Safecast/bGeigieZen/hardware/bGeigieZen V4.x.x draft and production/bGeigieZen V4.2.x/bGeigieZen V4.2.x.kicad_pcb

## KiCad design hardware/bGeigieZen V4.x.x draft and production/bGeigieZen V4.2.x/bGeigieZen V4.2.x.kicad_pcb (2026-08-11)

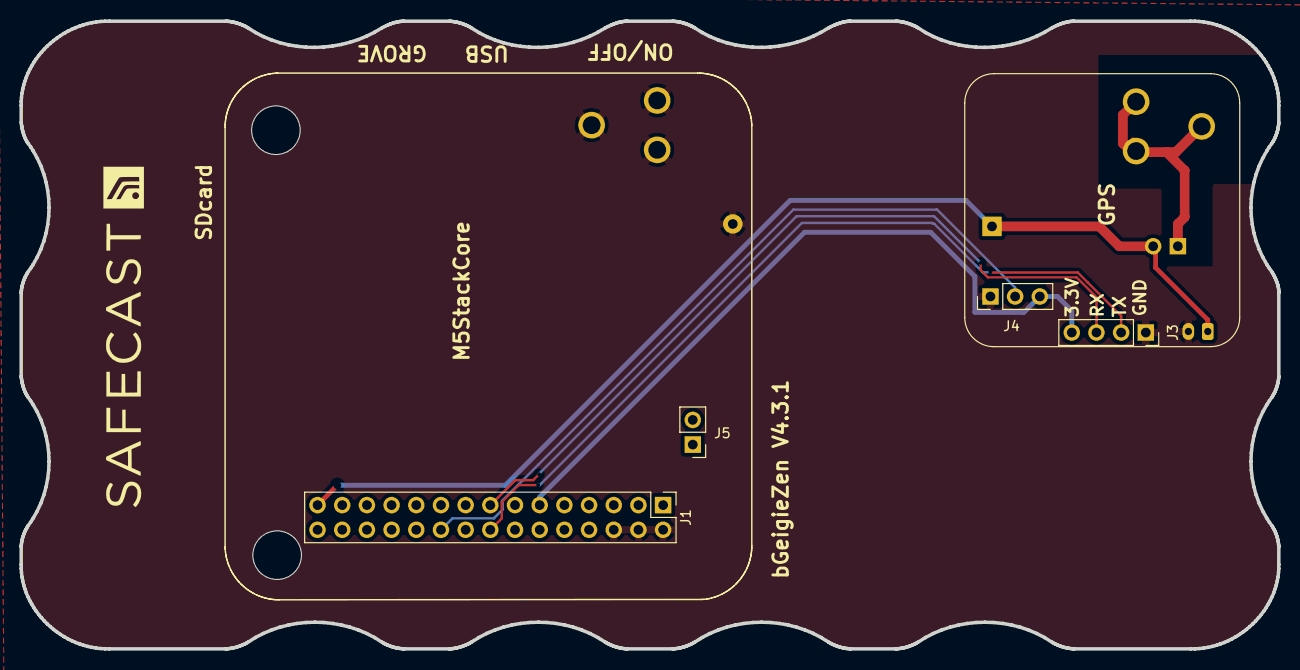
[picture p1: board bGeigieZen V4.2.x.kicad_pcb from above]

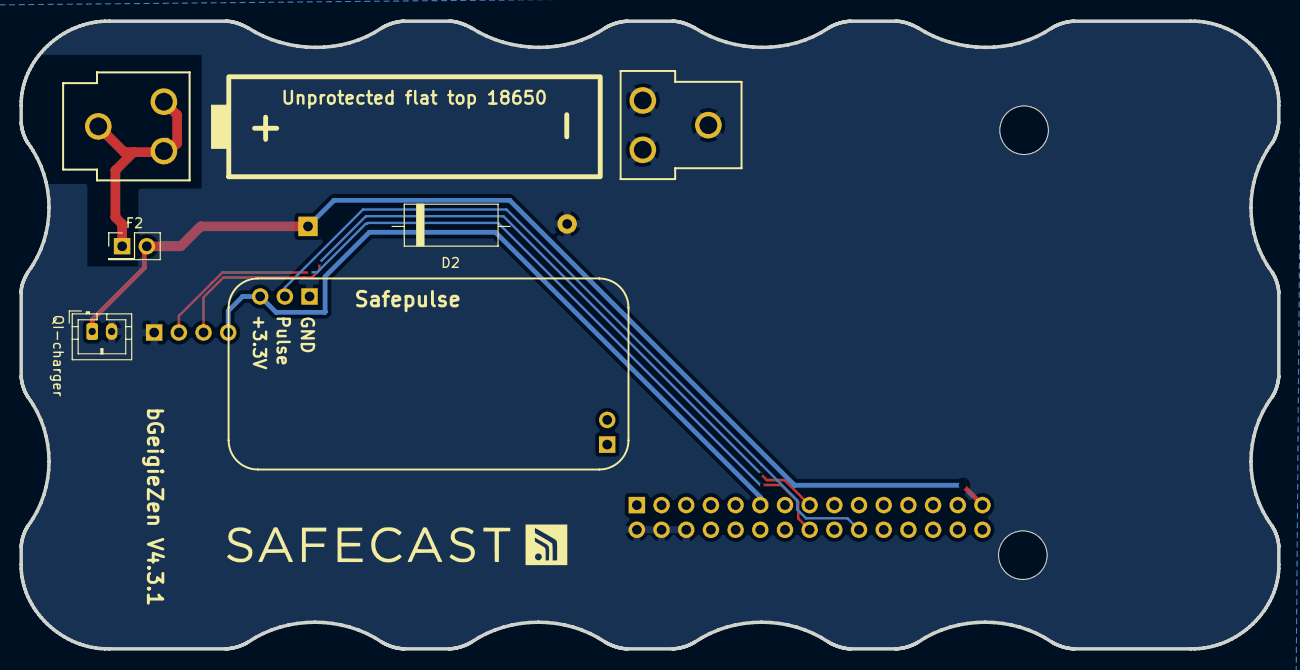
[picture p2: board bGeigieZen V4.2.x.kicad_pcb from below]

Board: 2 copper layers, 129.4 x 64.6 mm, 12 parts (5 on the bottom side), 7 nets.

Parts:
BT1: 3.7 V Lipo; BATTERY_18650-HOLDER
D2: Crowbar; D_DO-201_P15.24mm_Horizontal
F2: Polyfuse; PinHeader_2x01_P2.54mm_Vertical
G back: LOGO
G front: LOGO
H4, H6: MountingHole_Pad; MountingHole_3.2mm_M3
J1: M5 2x15 pin; PinHeader_2x15_P2.54mm_Vertical
J3: GPS; PinSocket_1x04_P2.54mm_Vertical
J4: Geiger Safepulse; PinHeader_1x03_P2.54mm_Vertical
J5: Extra support header; PinHeader_1x02_P2.54mm_Vertical
QI-charger: QI GND; JST_PH_B2B-PH-K_1x02_P2.00mm_Vertical

Connections:
3.3V: J1.11, J3.4, J4.3
/BAT: D2.1 (K), F2.2, J1.29, QI-charger.1
/GIO2 on Core and GIO32 on Core-2: J1.20, J4.2
/RX2: J1.15, J3.3
/TX2: J1.16, J3.2
GND: BT1.1 (+), BT1.PWR@2, BT1.PWR@3, D2.2 (A), J1.2, J1.4, J1.6, J3.1, J4.1, QI-charger.2
unnamed: BT1.1 (+), F2.1
