Safecast/bGeigieZen/hardware/bGeigieZen V3.x.x production/bGeigieZen V3.x.x production.kicad_pcb

## KiCad design hardware/bGeigieZen V3.x.x production/bGeigieZen V3.x.x production.kicad_pcb (2024-08-04)

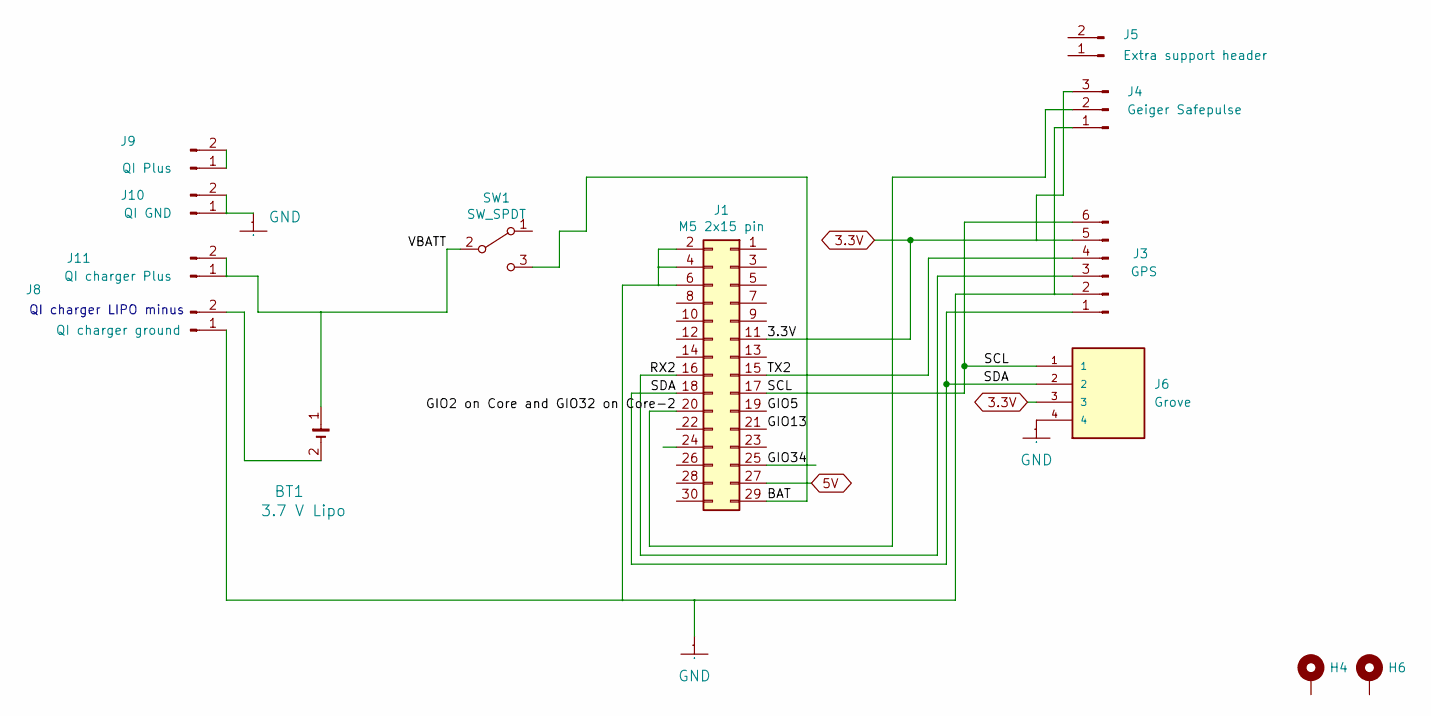
[picture p6: schematic bGeigieZen V3.x.x production.kicad_sch, bGeigieZen V3.0.6]

Parts:
BT1: 3.7 V Lipo; BATTERY_18650-HOLDER
H4, H6: MountingHole_Pad; MountingHole_3.2mm_M3
J1: M5 2x15 pin; PinHeader_2x15_P2.54mm_Vertical
J3: GPS; PinSocket_1x06_P2.54mm_Vertical
J4: Geiger Safepulse; PinHeader_1x03_P2.54mm_Vertical
J5: Extra support header; PinHeader_1x02_P2.54mm_Vertical
J6: Grove; PinSocket_1x04_P2.00mm_Horizontal; PARTREV A
J8: QI charger ground; PinHeader_1x02_P2.54mm_Vertical
J9: QI Plus; PinHeader_1x02_P2.54mm_Vertical
J10: QI GND; PinHeader_1x02_P2.54mm_Vertical
J11: QI charger Plus; PinHeader_1x02_P2.54mm_Vertical_4056
SW1: SW_SPDT; EG1206

Connections:
3.3V: J1.11, J3.5, J4.3, J6.3
5V: J1.27
/BAT: J1.29, SW1.3 (C)
/GIO2 on Core and GIO32 on Core-2: J1.20, J4.2
/GIO5: J1.19
/GIO13: J1.21
/GIO34: J1.25
/RX2: J1.16, J3.3
/SCL: J1.17, J3.6, J6.1
/SDA: J1.18, J3.1, J6.2
/TX2: J1.15, J3.4
/VBATT: BT1.1 (+), BT1.PWR@2, BT1.PWR@3, J11.1, J11.2, SW1.2 (B)
GND: J1.2, J1.4, J1.6, J3.2, J4.1, J6.4, J8.1, J10.1, J10.2
unnamed: BT1.2 (-), J8.2
unnamed: J9.1, J9.2

Notes on the sheet:
QI charger LIPO minus

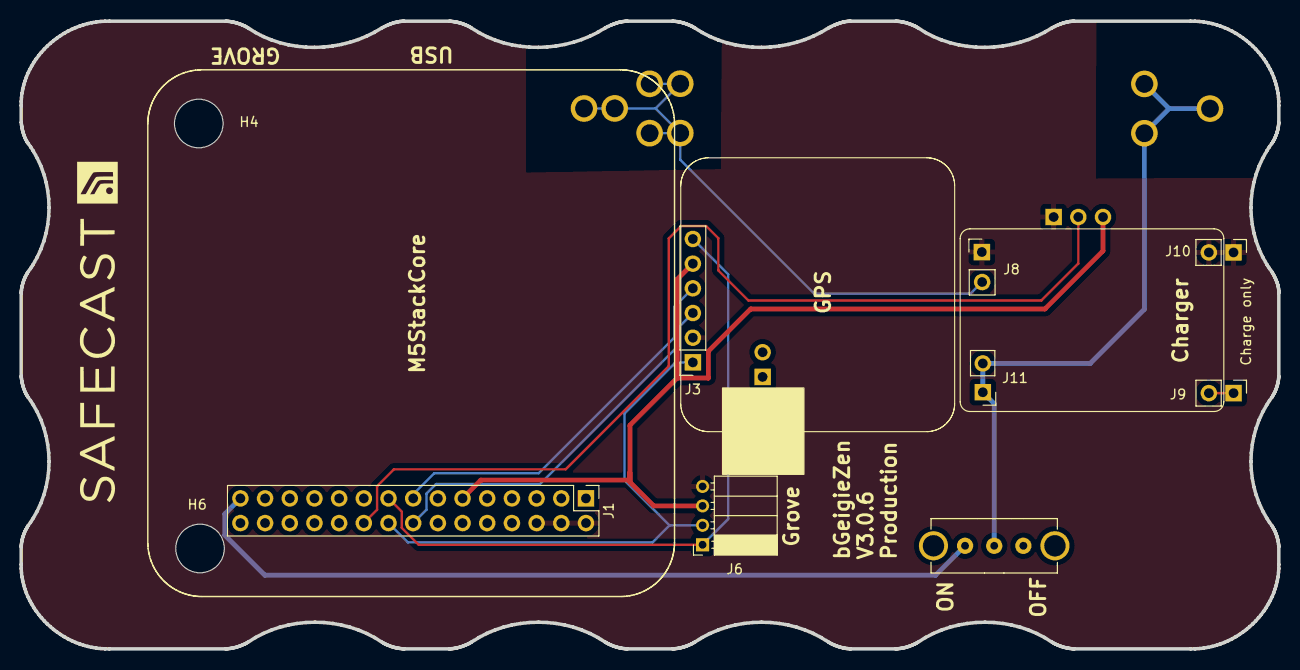
[picture p7: board bGeigieZen V3.x.x production.kicad_pcb from above]

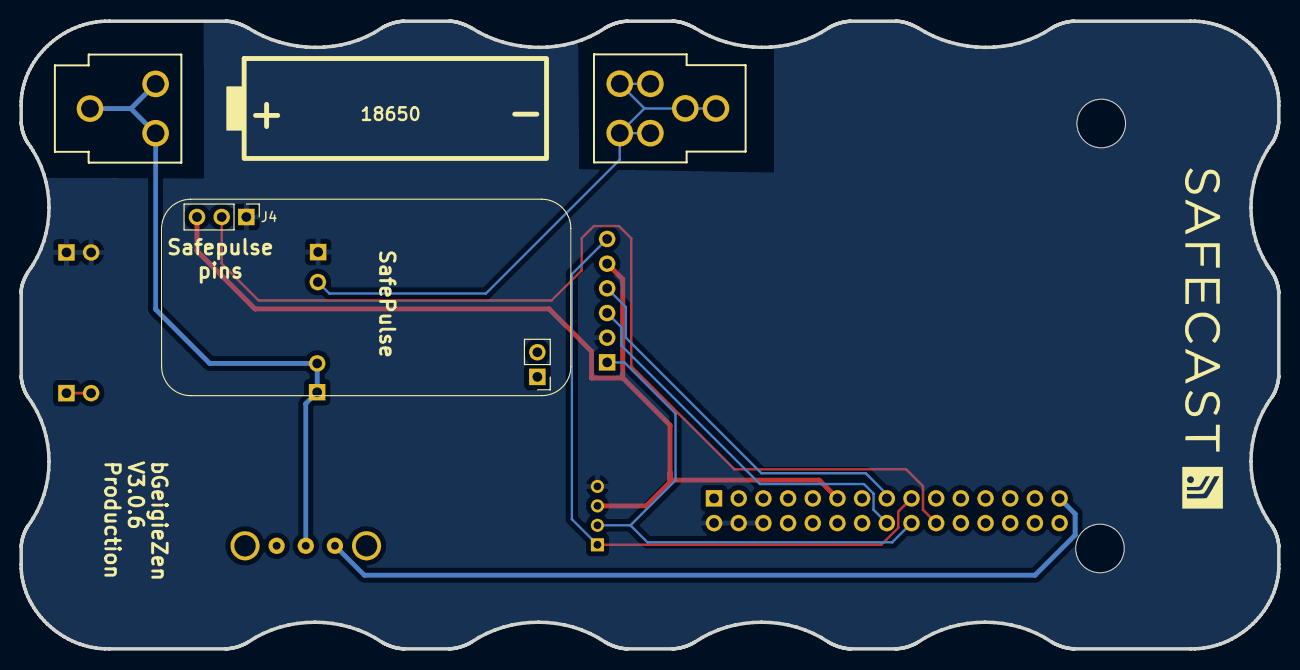
[picture p8: board bGeigieZen V3.x.x production.kicad_pcb from below]

Board: 2 copper layers, 129.4 x 64.6 mm, 15 parts (2 on the bottom side), 11 nets.

Other parts of the board:
G back: LOGO
G front: LOGO
