Safecast/bGeigieZen/hardware/bGeigieZen V4.x.x beta/bGeigieZen V4.x.x beta.kicad_pcb

## KiCad design hardware/bGeigieZen V4.x.x beta/bGeigieZen V4.x.x beta.kicad_pcb (2024-02-28)

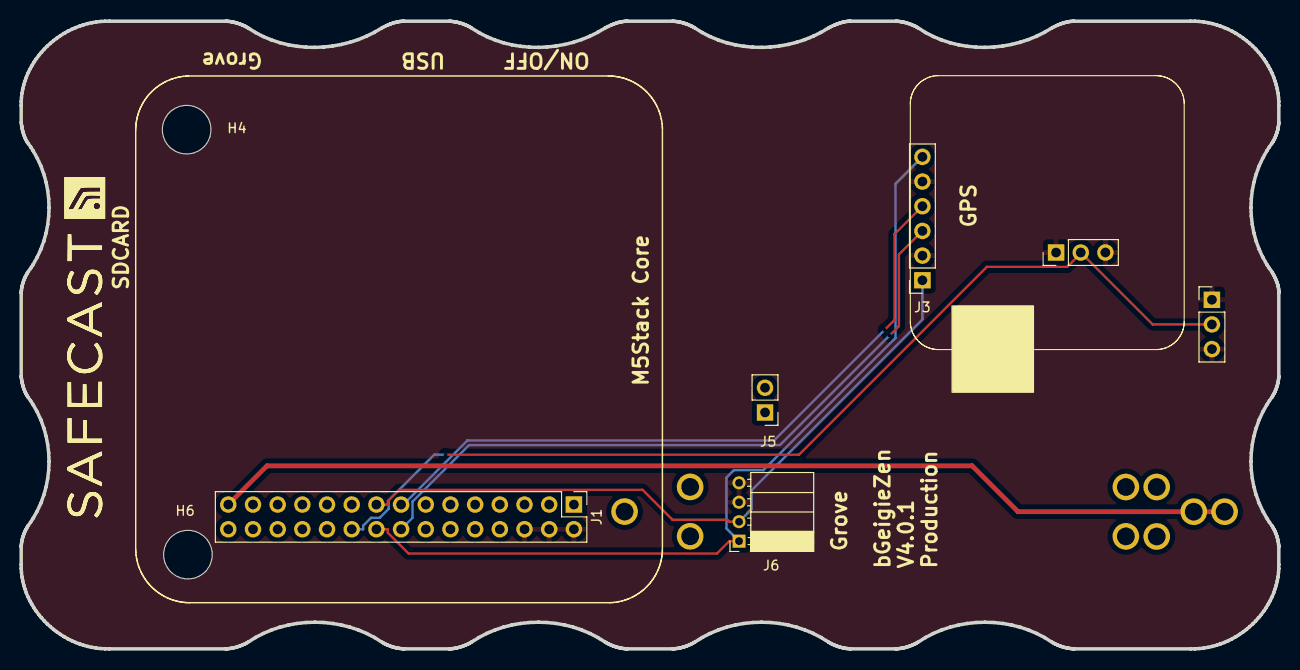
[picture p9: board bGeigieZen V4.x.x beta.kicad_pcb from above]

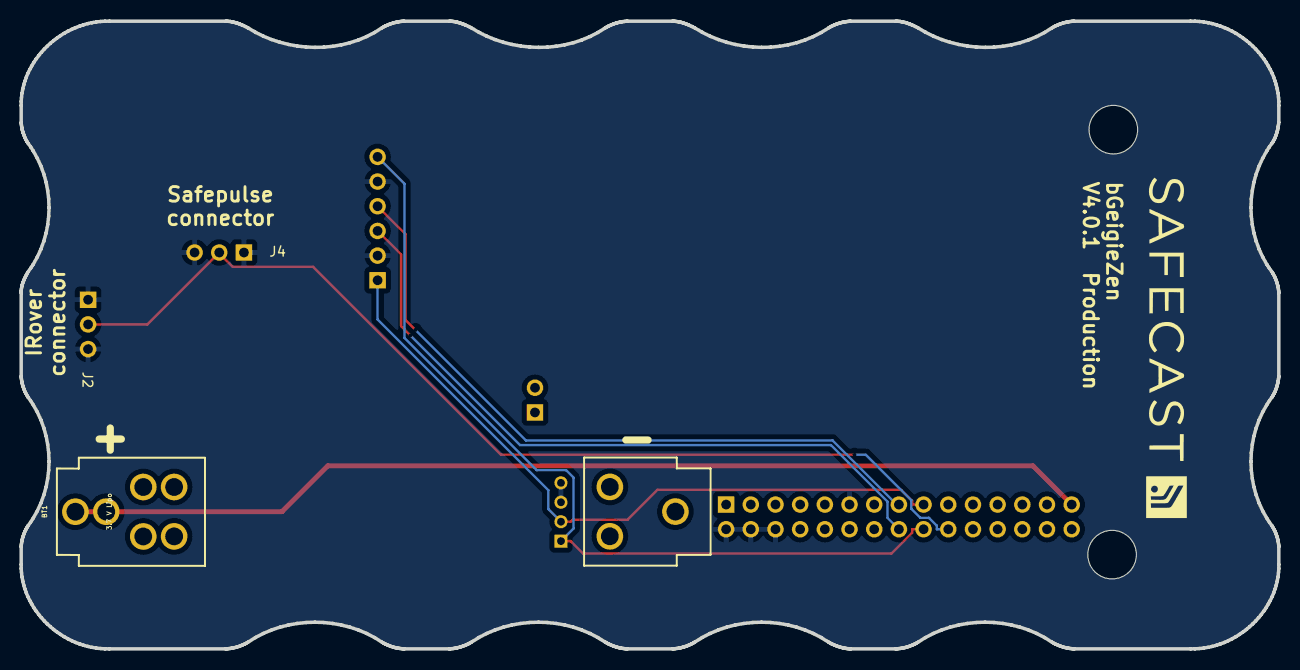
[picture p10: board bGeigieZen V4.x.x beta.kicad_pcb from below]

Board: 2 copper layers, 129.4 x 64.6 mm, 11 parts (2 on the bottom side), 7 nets.

Parts:
BT1: 3.7 V Lipo; BATTERY_18650-HOLDER
G back: LOGO
G front: LOGO
H4, H6: MountingHole_Pad; MountingHole_3.2mm_M3
J1: M5 2x15 pin; PinHeader_2x15_P2.54mm_Vertical
J2: Geiger IRover; PinHeader_1x03_P2.54mm_Vertical
J3: GPS; PinSocket_1x06_P2.54mm_Vertical
J4: Geiger Safepulse; PinHeader_1x03_P2.54mm_Vertical
J5: Extra support header; PinHeader_1x02_P2.54mm_Vertical
J6: Grove; PinSocket_1x04_P2.00mm_Horizontal

Connections:
3.3V: J1.2, J1.4, J1.6, J1.11, J2.1, J2.3, J3.2, J3.5, J4.1, J4.3, J6.3, J6.4
/BAT: BT1.1 (+), J1.29
/GIO2 on Core and GIO32 on Core-2: J1.20, J2.2, J4.2
/RX2: J1.15, J3.4
/SCL: J1.18, J3.6, J6.1
/SDA: J1.17, J3.1, J6.2
/TX2: J1.16, J3.3
