Safecast/bGeigieZen/hardware/bGeigieZen V4.x.x draft and production/bGeigieZen V4.2.x/temp copy.kicad_pcb

## KiCad design hardware/bGeigieZen V4.x.x draft and production/bGeigieZen V4.2.x/temp copy.kicad_pcb (2020-07-29)

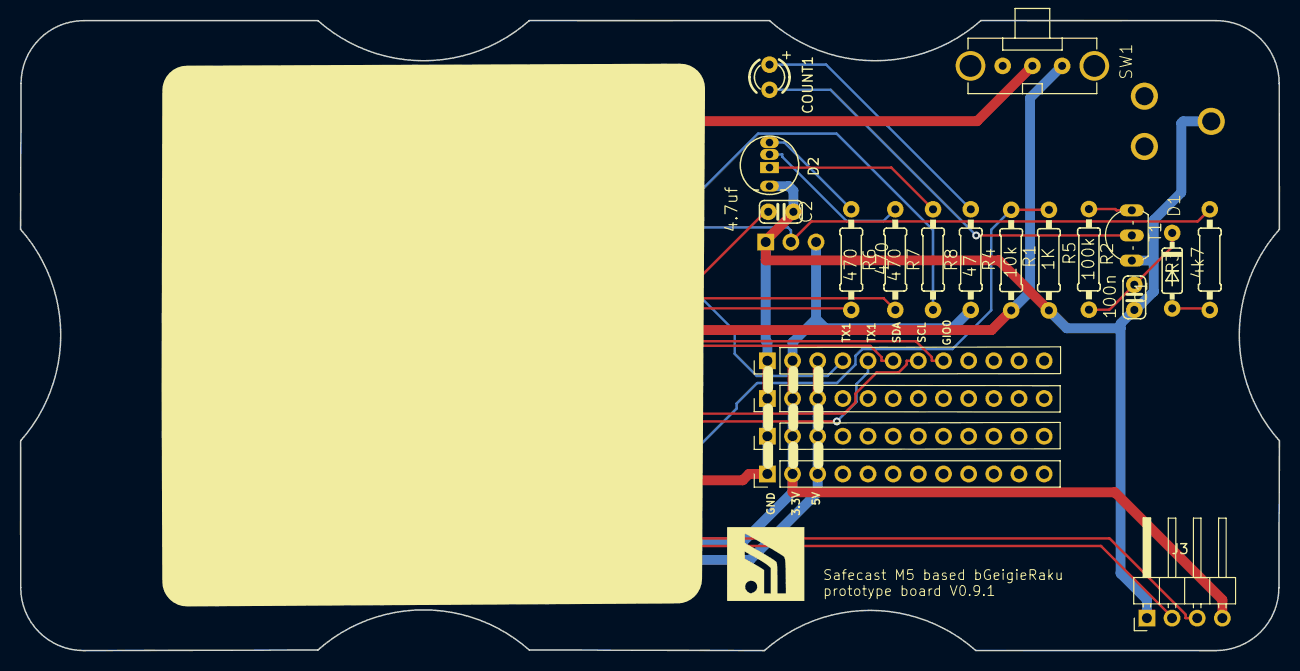
[picture p11: board temp copy.kicad_pcb from above]

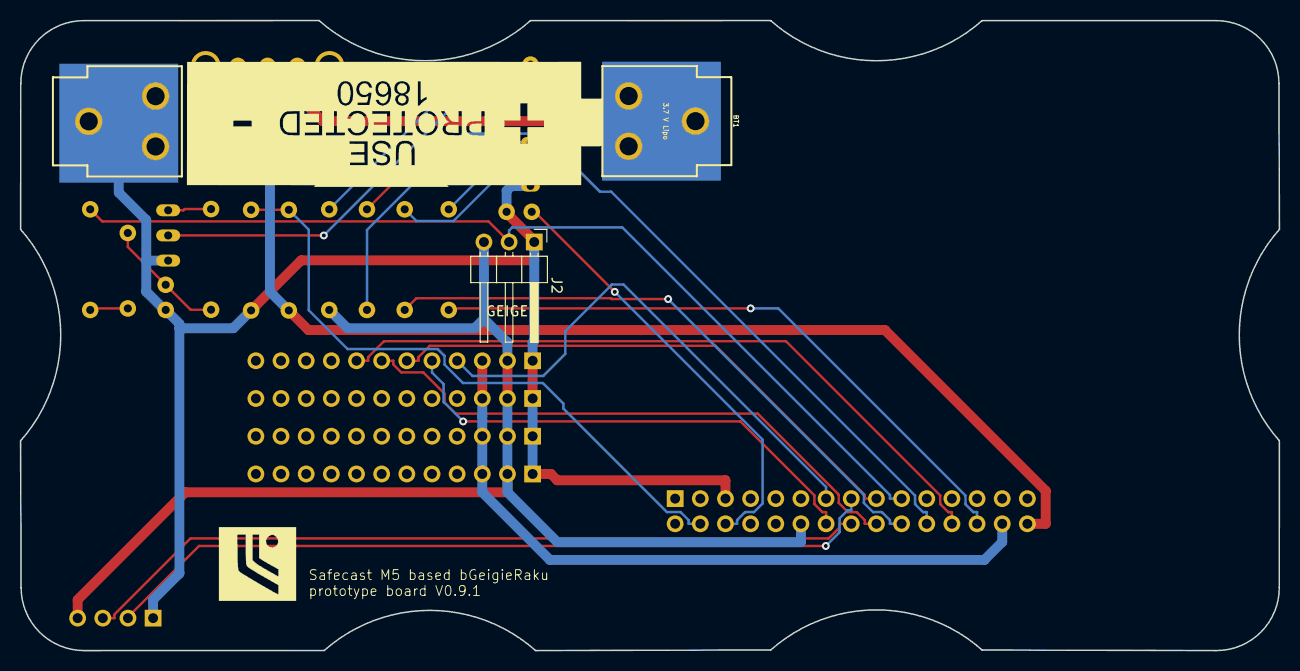
[picture p12: board temp copy.kicad_pcb from below]

Board: 2 copper layers, 127.1 x 63.6 mm, 25 parts (3 on the bottom side), 26 nets.

Parts:
BT1: 3.7 V Lipo; BATTERY_18650-HOLDER
C1: 100n; C025-024X044
C2: 4.7uf; C025-024X044
COUNT1: BLUE; LED3MM
D1: 1N4148; DO35-7
D2: LED_CRGB; LED-RGB-5MM_Common_Cathode
J1: M5 2x15 pin; PinHeader_2x15_P2.54mm_Vertical
J2: Geiger; PinHeader_1x03_P2.54mm_Horizontal
J3: GPS; PinHeader_1x04_P2.54mm_Horizontal
J4, J5, J6, J7: Conn_01x14_Female; PinHeader_1x14_P2.54mm_Vertical
Logo1: LOGO; safecast_logo_inverted
Logo 2: LOGO; safecast_logo_inverted
R1: 10k; 0207_10
R2: 1K; 0207_10
R3: 4k7; 0207_10
R4: 47; 0207_10
R5: 100k; 0207_10
R6, R7, R8: 470; 0207_10
SW1: SW_SPDT; EG1206
T1: 2SC1815; TO92-ECB

Connections:
3.3V: J1.12, J2.3, J3.4, J4.2, J5.2, J6.2, J7.2, R4.1
5V: J1.28, J4.3, J5.3, J6.3, J7.3
+5V: BT1.1, SW1.2
/GIO0: J1.24, J7.8
/GIO2: J1.19, J2.2, R3.1
/GIO5: J1.20, R7.2
/GIO13: J1.22, R8.2
/GIO34: J1.26, R6.2
/RX1: J1.14, J7.5
/RX2: J1.16, J3.3
/Reset: C2.1, J1.6
/SCL: J1.18, J7.7
/SDA: J1.17, J7.6
/TX1: J1.13, J7.4
/TX2: J1.15, J3.2
GND: BT1.2, C1.2, C2.2, D2.1, J1.5, J2.1, J3.1, J4.1, J5.1, J6.1, J7.1, R2.2, T1.E
unnamed: C1.1, D1.C, R5.1
unnamed: COUNT1.A, R4.2
unnamed: COUNT1.K, T1.C
unnamed: D1.A, R3.2
unnamed: D2.2, R8.1
unnamed: D2.3, R7.1
unnamed: D2.4, R6.1
unnamed: J1.4, R1.2, R2.1
unnamed: J1.30, R1.1, SW1.1
unnamed: R5.2, T1.B
