Safecast/bGeigieZen/(notices)

Notices in the files:
Misc documents and software/3d models/Notecarrier-Mirco/Notecarrier-Micro/Notecarrier-Micro.kicad_pcb:
Blues Inc (Copyright (c) 2023 Blues Inc)
